OwenAsbridge/Autonomous-Pick-and-Place-Robot/(commit log)

2026-08-20 Rename Full robot assembly.png to media/Full robot assembly.png
2026-08-20 Rename Gripper claw with color sensor detail.png to media/Gripper claw with color sensor detail.png
2026-08-20 Rename Full robot assembly.png to Full_robot_assembly.png
2026-08-20 Rename Gripper claw with color sensor detail.png to Gripper_detail.png
